zteifel/esphome-gecko/(commit log)

2025-12-27 Fix status parsing, connection tracking, and temperature handling
    - Program detection from spa: use publish_state() instead of
    make_call().perform() to avoid command loop
    - Ignore config dump messages (byte[6]=0x0B) - only parse status
    messages where byte[6]=0x0A
    - Connected sensor: track any I2C traffic with 5-minute timeout
    - Standby/Connected sensors: publish initial state on entity
    registration to clear "Unknown"
    - Temperature: preserve existing values when message doesn't contain
    valid temperature data (prevents 0 degree resets)
    [spa_protocol.h]
2025-12-30 Fix notification parsing offset: entries start at byte 16, not 17
    [gecko_spa.cpp]
2026-01-02 Simplify to single hex file for all ATmega328P boards
    Both old and new bootloader Nanos use the same ATmega328P chip,
    so the compiled hex is identical - only upload baud rate differs:
    - New bootloader (clones): 115200 baud
    - Old bootloader (original): 57600 baud
2026-01-03 Auto-reset Arduino on spa disconnect
    - Add reset_pin config option to gecko_spa component
    - Automatically reset Arduino when spa connection times out (5 min)
    - Reset is non-blocking (100ms pulse handled in loop)
    - Manual reset button still available via reset_arduino() method
    - Remove Arduino reset from TODO list
    [spa-controller.yaml]
2026-11-07 Fix temperature encoding and climate traits
    Send the setpoint as a 16-bit big-endian value so temps below 28.5C
    no longer wrap (26C was sent as 40.2C). Use climate feature flags so
    current temperature shows on newer ESPHome (fixes #25).
2026-11-08 Fix status parsing on idle spa and sensor include
    Parse the status tail of combined config messages without waiting for a
    standalone status, validating alignment by setpoint (#27). Auto-load the
    sensor component so configs without sensors compile (#19).
2026-11-08 Detect Arduino freezes and add serial proxy mode
    Reset the Arduino as soon as a TX goes unanswered for 1s instead of after
    60s without traffic, logging the TX that froze it and counting freezes.
    With serial_proxy_id set, pause the spa protocol while a proxy client is
    connected so the Arduino can be reflashed over WiFi.
2026-11-08 Add Arduino proxy V2 and WiFi flashing tool
    Enable the Wire timeout so I2C collisions can't hang the proxy, and report
    I2C failures as TX:ERR. Bundle a Wire library with 128-byte buffers: the
    stock Wire.h hard-codes 32, overflowing on 78-byte messages when built from
    source. tools/arduino_ota.py flashes the Arduino through the ESP32's
    serial_proxy, so no USB access is needed.
2026-11-08 Ignore glitch bytes on the Arduino UART
2026-11-08 Add spa clock sync from Home Assistant time
    Sets the spa clock with the same Y-M-D layout the spa reports, from a
    button or automatically on drift over 2 min. Sent 10 s after the GO
    handshake: right after it the spa acknowledges but ignores the command.
